DexterLB/varibulb/README.md

An incandescent/halogen light intensity controller that fits in a switch
slot and uses a triac phase cutout for regulating the power
