DexterLB/varibulb/pcb/prints/schematic.pdf

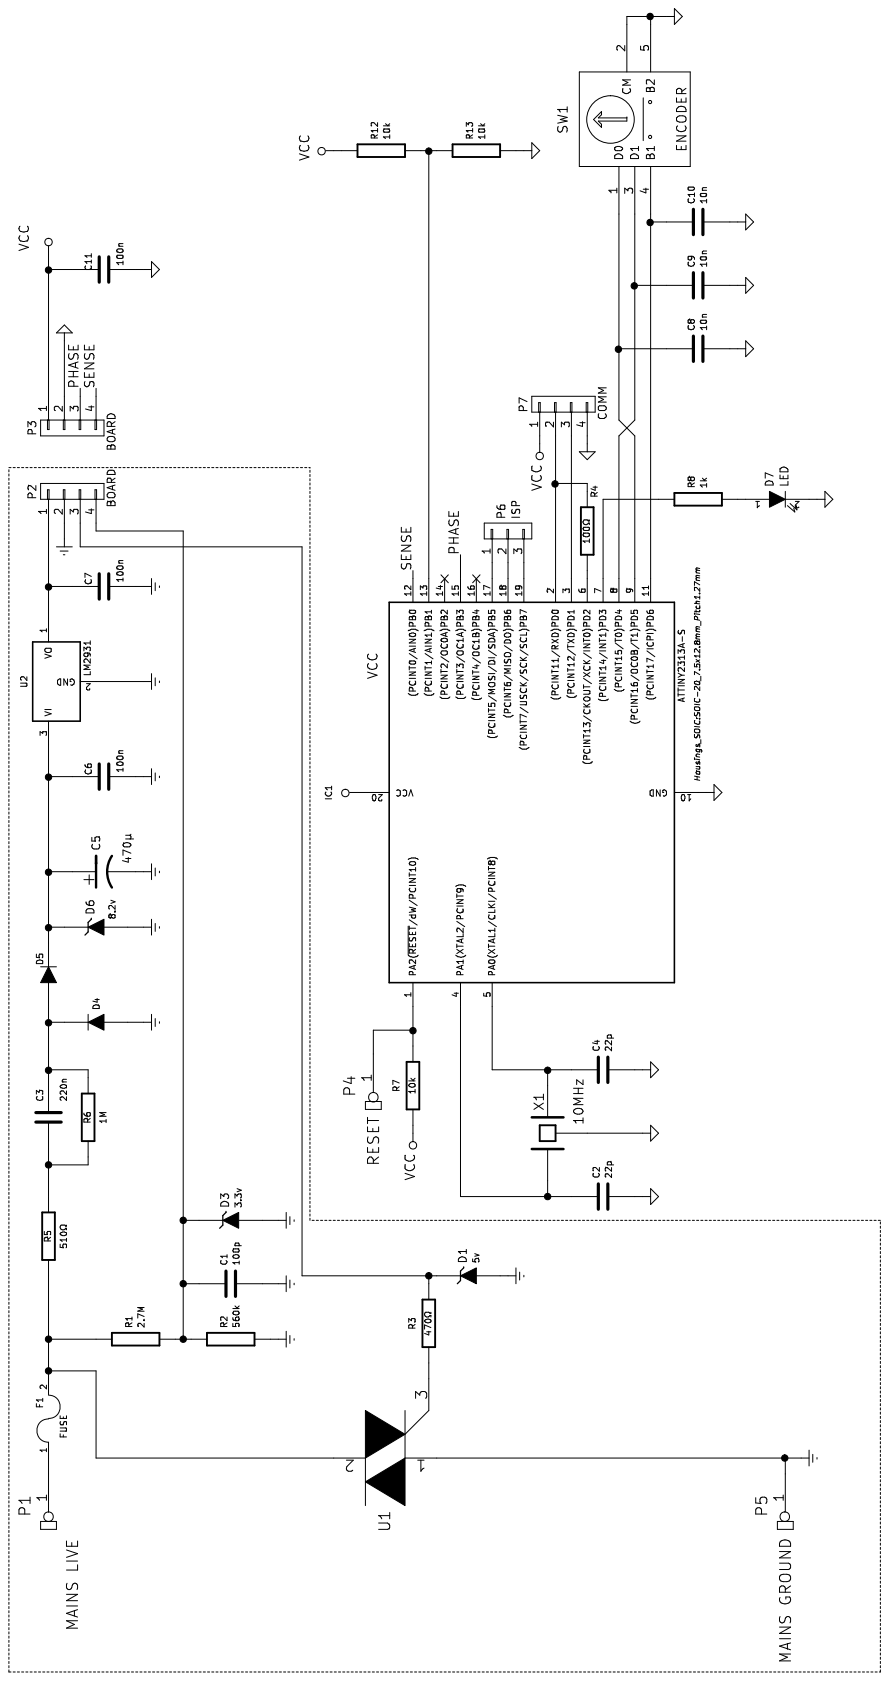
[picture p1: page 1]
