DexterLB/varibulb/pcb/prints/pcb_bot.pdf

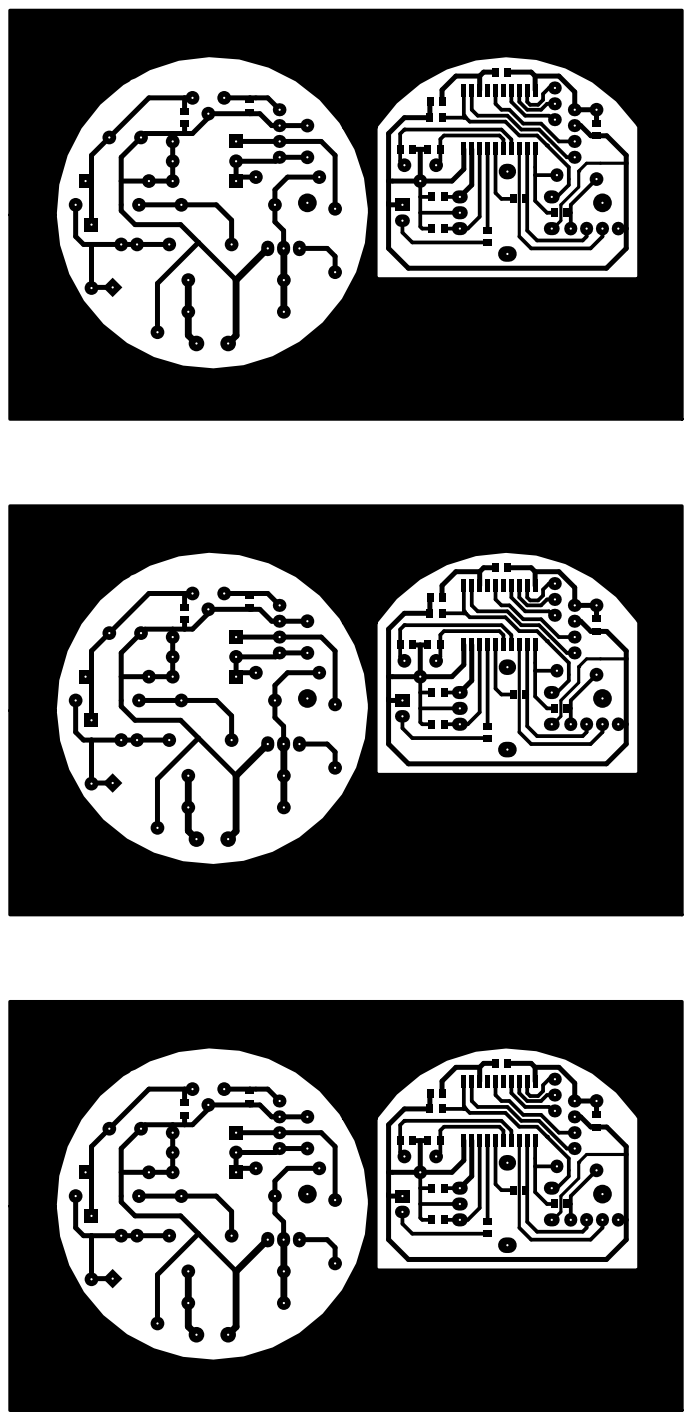
[picture p2: page 1]
