DexterLB/varibulb/pcb/varibulb.kicad_pcb

## KiCad design pcb/varibulb.kicad_pcb (2016-03-09)

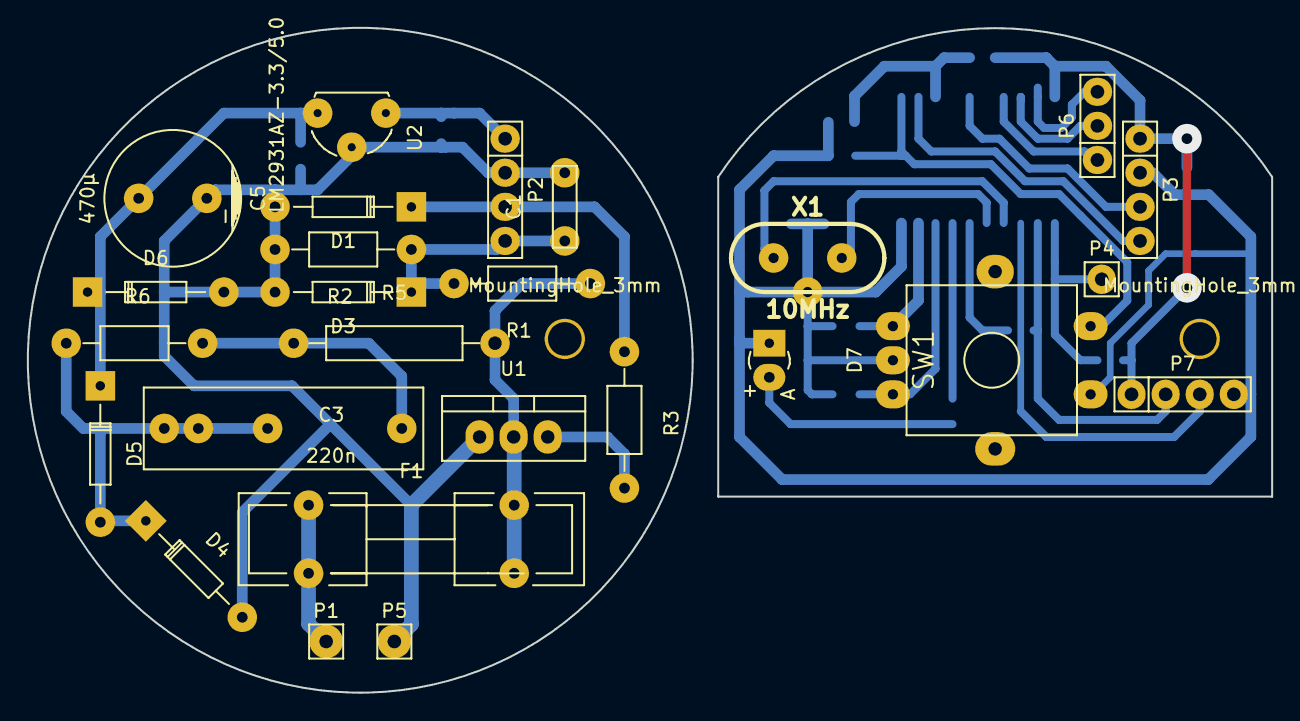
[picture p3: board varibulb.kicad_pcb from above]

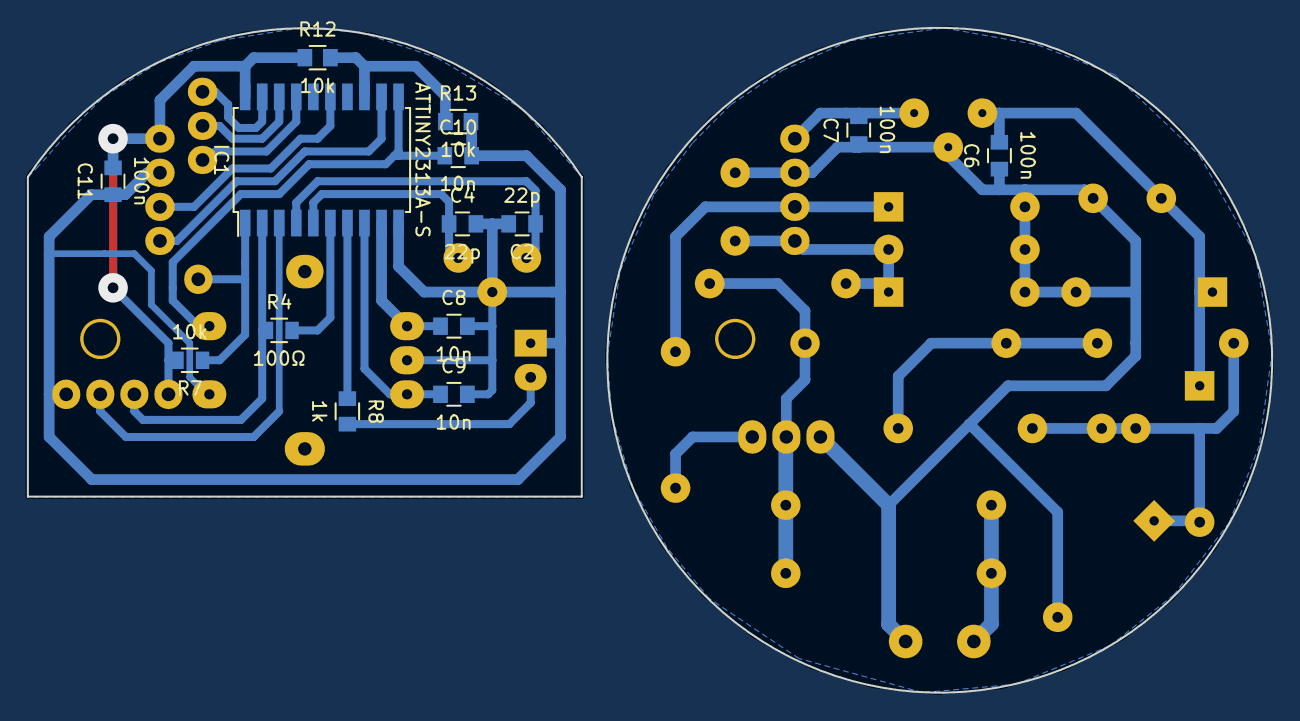
[picture p4: board varibulb.kicad_pcb from below]

Board: 2 copper layers, 92.7 x 49.5 mm, 42 parts (14 on the bottom side), 29 nets.

Parts:
C1: 100p; Capacitor6MMDiscRM5
C2, C4: 22p; C_0805
C3: 220n; Capacitor13x6x12mmRM10
C5: 470μ; Capacitor10x16RM5
C6, C7, C11: 100n; C_0805
C8, C9, C10: 10n; C_0805
D1: 5v; Diode_DO-35_SOD27_Horizontal_RM10
D3: 3.3v; Diode_DO-35_SOD27_Horizontal_RM10
D4, D5: DIODE; Diode_DO-35_SOD27_Horizontal_RM10
D6: 8.2v; Diode_DO-35_SOD27_Horizontal_RM10
D7: LED; Diode_LED_3mm_round_vertical
F1: FUSE; Fuseholder5x20_horiz_open_lateral_Type-II
IC1: ATTINY2313A-S; SOIC-20_7.5x12.8mm_Pitch1.27mm
MountingHole_3mm, MountingHole_3mm#2: VAL**; MountingHole_3mm
P1: MAINS LIVE; Pin_Header_Straight_1x01
P2, P3: BOARD; Pin_Header_Straight_1x04
P4: RESET; Pin_Header_Straight_1x01
P5: MAINS GROUND; Pin_Header_Straight_1x01
P6: ISP; Pin_Header_Straight_1x03
P7: COMM; Pin_Header_Straight_1x04
R1: 2.7M; Resistor_Horizontal_RM10mm
R2: 560k; Resistor_Horizontal_RM10mm
R3: 470Ω; Resistor_Horizontal_RM10mm
R4: 100Ω; R_0805
R5: 510Ω; Resistor_Horizontal_RM15mm
R6: 1M; Resistor_Horizontal_RM10mm
R7, R12, R13: 10k; R_0805
R8: 1k; R_0805
SW1: ENCODER
U1: TRIAC; TO-220_Neutral123_Vertical
U2: LM2931AZ-3.3/5.0; TO-92-Free-molded-wide
X1: 10MHz; HC-49V

Connections:
/PHASE: IC1.15, P3.3
/SENSE: IC1.12, P3.4
GND: C2.2, C4.2, C8.2, C9.2, C10.2, C11.1, D7.2, IC1.10, P3.2, P7.4, R13.2, SW1.2, SW1.5, X1.0
GNDREF: C1.2, C5.2, C6.1, C7.1, D1.1, D3.1, D4.1, D6.1, P2.2, P5.1, R2.2, U1.1, U2.2
unnamed: C1.1, D3.2, P2.4, R1.2, R2.1
unnamed: C2.1, IC1.4, X1.1
unnamed: C3.1, D4.2, D5.1, R6.1
unnamed: C3.2, R5.1, R6.2
unnamed: C4.1, IC1.5, X1.2
unnamed: C5.1, C6.2, D5.2, D6.2, U2.3
unnamed: C7.2, P2.1, U2.1
unnamed: C8.1, IC1.9, SW1.1
unnamed: C9.1, IC1.8, SW1.3
unnamed: C10.1, IC1.11, SW1.4
unnamed: D1.2, P2.3, R3.1
unnamed: D7.1, R8.2
unnamed: F1.1, P1.1
unnamed: F1.2, R1.1, R5.2, U1.2
unnamed: IC1.1, P4.1, R7.1
unnamed: IC1.2, P7.2, R4.1
unnamed: IC1.3, P7.3
unnamed: IC1.6, R4.2
unnamed: IC1.7, R8.1
unnamed: IC1.13, R12.2, R13.1
unnamed: IC1.17, P6.1
unnamed: IC1.18, P6.2
unnamed: IC1.19, P6.3
unnamed: R3.2, U1.3
VCC: C11.2, IC1.20, P3.1, P7.1, R7.2, R12.1
