DexterLB/varibulb/(commit log)

2016-02-06 start drawing schematic
    [varibulb.kicad_pcb, varibulb.sch]
2016-02-06 finish power supply
    [varibulb.sch]
2016-02-06 finish overall schematic
    [varibulb.sch]
2016-02-06 fix wrong line
    [varibulb.sch]
2016-02-15 remake schematic to use a capacitor for power conversion
    [varibulb.sch]
2016-02-16 annotate schematic and fix erc errors
    [varibulb.sch]
2016-02-16 fix some values
    [varibulb.sch]
2016-02-21 use timer's output compare for waveform generation
2016-02-21 use short pulses for triac
    [main.c]
2016-02-21 add encoder decoding
2016-02-22 add componente to pcb
    [varibulb.kicad_pcb, varibulb.sch]
2016-02-22 arrange some components
    [varibulb.kicad_pcb]
2016-02-22 arrange more components
    [varibulb.kicad_pcb, varibulb.sch]
2016-02-22 two PCBs
    [varibulb.kicad_pcb, varibulb.sch]
2016-02-22 arrange power pcb
    [varibulb.kicad_pcb, varibulb.sch]
2016-02-25 set appropriate track widths
    [varibulb.kicad_pcb]
2016-02-25 move capacitor
    [varibulb.kicad_pcb]
2016-02-25 this sucks so much..
    [varibulb.kicad_pcb, varibulb.sch]
2016-02-26 arrange some more components
    [varibulb.kicad_pcb, varibulb.sch]
2016-02-28 finish pcb
    [varibulb.kicad_pcb, varibulb.sch]
2016-02-28 add filled zone
    [varibulb.kicad_pcb]
2016-02-29 remove the filled zone
    [varibulb.kicad_pcb]
2016-02-29 center edge outlines properly
    [varibulb.kicad_pcb]
2016-02-29 bigger capacitors
    [varibulb.kicad_pcb, varibulb.sch]
2016-02-29 activate avr internal pullup resistors
2016-03-01 update schematic to last changes
    [varibulb.sch]
2016-03-09 make PCB prints
    [varibulb.kicad_pcb]
2016-03-09 flip print
2016-03-09 prettify schematic print
    [varibulb.sch]
